shreyas-7/TouchTheScreen/Initial_Codes/tkinter.py

from Tkinter import *

def showPosEvent(event):
    print 'Widget=%s X=%s Y=%s' % (event.widget, event.x, event.y)


def onDoubleLeftClick(event):
    print 'Got double left mouse click',
    showPosEvent(event)
    tkroot.quit()

tkroot = Tk()
labelfont = ('courier', 20, 'bold')  
widget = Label(tkroot, text='Hello bind world')
widget.config(bg='red', font=labelfont)
widget.config(height=5, width=20)      
widget.pack(expand=YES, fill=BOTH)

widget.bind('<Double-1>',  onDoubleLeftClick)

widget.focus()                               
tkroot.title('Click Me')
tkroot.mainloop()
