shreyas-7/TouchTheScreen/(commit log)

2017-05-26 Create one_led.py
    This code moves the mouse pointer to the pixel address (100,200), when an obstacle (your finger) is placed in between the IR LED and photo diode.
2017-05-26 Create one_led.ino
    Upload this code to Arduino, and run python code one_led.py
